naoufalelhlou22/co-detector-controller/audit_rev3/netlist/connectivity.txt

C1 [47uF_35V] 1=+12V, 2=GND
C2 [10uF_50V] 1=+12V, 2=GND
C3 [10uF_50V] 1=+12V, 2=GND
C4 [100nF] 1=+12V, 2=GND
C5 [100nF] 1=BUCK_BOOT, 2=BUCK_SW
C6 [1uF] 1=BUCK_VCC, 2=GND
C7 [DNP] 1=BUCK_FB, 2=+3V3
C8 [22uF_10V] 1=+3V3, 2=GND
C9 [22uF_10V] 1=+3V3, 2=GND
C10 [22uF_10V] 1=+3V3, 2=GND
C11 [22uF_10V] 1=+3V3, 2=GND
C12 [100nF] 1=+3V3, 2=GND
C13 [10uF_10V] 1=AGND, 2=AVDD
C14 [100nF] 1=AGND, 2=AVDD
C15 [10uF_10V] 1=GND, 2=+3V3
C16 [100nF] 1=GND, 2=+3V3
C17 [100nF] 1=VOUT_ADC, 2=GND
C18 [100nF] 1=AGND, 2=AVDD
C19 [100nF] 1=AVDD, 2=AGND
C20 [100nF] 1=VREF, 2=AGND
C21 [1uF] 1=TIA_C1, 2=TIA_C2
C22 [100nF] 1=GND, 2=+3V3
C23 [100nF] 1=GND, 2=+3V3
C24 [100nF_50V] 1=+12V, 2=GND
C25 [100nF] 1=VALVE_SENSE, 2=GND
C26 [100nF_50V] 1=+12V, 2=GND
C27 [100nF] 1=TEST_N, 2=GND
C28 [100nF] 1=GND, 2=LPG_ADC
C29 [100nF] 1=+3V3, 2=GND
C30 [100nF] 1=HUSH_N, 2=GND
C31 [100nF] 1=GND, 2=MR_N
D1 [SMBJ15A] 1=+12V_F, 2=GND
D2 [B240A] 1=+12V, 2=VALVE_NEG
D3 [BZT52C15] 1=+12V, 2=Q1_G
D4 [RED_ALARM] 1=GND, 2=RED_A
D5 [GRN_OK] 1=GND, 2=GRN_A
D6 [BLU_WIFI] 1=BLU_K, 2=BLU_A
D7 [DNP] 1=+12V, 2=BUZ_K
D8 [YLW_FAULT] 1=TEST_N, 2=YLW_A
D9 [TVS_3V3_ESD] 1=TEST_N, 2=GND
D10 [TVS_3V3_ESD] 1=HUSH_N, 2=GND
D11 [TVS_3V3_ESD] 1=MR_N, 2=GND
F1 [1.5A_PTC] 1=+12V_IN, 2=+12V_F
FB1 [220R_100MHz] 1=+3V3, 2=AVDD
FID1 [FID_BL] 
FID2 [FID_TR] 
H1 [M3_NPTH] 
H2 [M3_NPTH] 
H3 [M3_NPTH] 
H4 [M3_NPTH] 
J1 [12V_IN] 1(+12V_IN_1)=+12V_IN, 2(GND_2)=GND
J2 [EXT_ALARM_12V] 1(EXT_ALM+_1)=+12V, 2(EXT_ALM-_2)=VALVE_NEG
J3 [UART_HDR] 1(3V3_1)=+3V3, 2(TX_2)=UART_TX, 3(RX_3)=UART_RX, 4(GND_4)=GND
J4 [OLED_I2C] 1(GND_1)=GND, 2(3V3_2)=+3V3, 3(SCL_3)=I2C_SCL, 4(SDA_4)=I2C_SDA
L1 [6.8uH] 1=BUCK_SW, 2=+3V3
LS1 [CDM-12008_SPKR] 1=+12V, 2=BUZ_K
NT1 [NetTie_AGND_GND] 1=GND, 2=AGND
Q1 [AO3407A] 1(G_1)=Q1_G, 2(S_2)=+12V, 3(D_3)=+12V_F
Q2 [IRLML6344] 1(G_1)=VALVE_GATE, 2(S_2)=GND, 3(D_3)=VALVE_NEG
Q3 [MMBFJ177_DNP] 1(D_1)=unconnected-(Q3-D-Pad1), 2(S_2)=unconnected-(Q3-S-Pad2), 3(G_3)=unconnected-(Q3-G-Pad3)
Q4 [2N7002] 1(G_1)=LED_BLU, 2(S_2)=GND, 3(D_3)=BLU_K
Q5 [AO3400A] 1(G_1)=BUZ_B, 2(S_2)=GND, 3(D_3)=BUZ_K
R1 [10k] 1=Q1_G, 2=GND
R2 [100k] 1=+12V, 2=BUCK_EN
R3 [DNP] 1=BUCK_EN, 2=GND
R4 [100k] 1=BUCK_FB, 2=+3V3
R5 [43.2k] 1=BUCK_FB, 2=GND
R6 [10k_DNP] 1=+3V3, 2=LPG_ADC
R7 [10k] 1=+3V3, 2=HUSH_N
R8 [10k] 1=+3V3, 2=BOOT_N
R9 [4.7k] 1=+3V3, 2=I2C_SDA
R10 [4.7k] 1=+3V3, 2=I2C_SCL
R11 [1k] 1=VOUT_ADC, 2=VOUT
R12 [DNP] 1=TIA_C1, 2=TIA_C2
R13 [10k] 1=VALVE_DRV, 2=VALVE_EN
R14 [100R] 1=VALVE_GATE, 2=VALVE_DRV
R15 [100k] 1=VALVE_GATE, 2=GND
R16 [100k] 1=VALVE_NEG, 2=VALVE_SENSE
R17 [15k] 1=VALVE_SENSE, 2=GND
R18 [DNP] 1=WDI, 2=GND
R19 [270R] 1=LED_RED, 2=RED_A
R20 [330R] 1=GRN_A, 2=+3V3
R21 [2.2k] 1=+12V, 2=BLU_A
R22 [100k] 1=LED_BLU, 2=GND
R23 [100R] 1=BUZZER, 2=BUZ_B
R24 [10k] 1=BUZ_B, 2=GND
R25 [47R] 1=+12V, 2=BUZ_K
R26 [10k] 1=TEST_N, 2=+3V3
R27 [22R_0.25W] 1=+3V3, 2=LPG_HTR
R28 [4.7k] 1=LPG_SNS, 2=GND
R29 [1k] 1=LPG_SNS, 2=LPG_ADC
R30 [330R] 1=+3V3, 2=YLW_A
S1 [ME3-CO] 1(WE_1)=WE, 2(RE_2)=RE, 3(CE_3)=CE
S2 [TGS2610-C00] 1(HTR-_1)=GND, 2(SNS-_2)=LPG_SNS, 3(SNS+_3)=+3V3, 4(HTR+_4)=LPG_HTR
SW1 [TEST_SELF_CHECK] 1=TEST_N, 2=GND
SW2 [HUSH_OLED] 1=HUSH_N, 2=GND
SW3 [HW_MASTER_RST] 1=MR_N, 2=GND
TP1 [+12V] 1(TP_1)=+12V
TP2 [+3V3] 1(TP_1)=+3V3
TP3 [AVDD] 1(TP_1)=AVDD
TP4 [GND] 1(TP_1)=GND
TP5 [VOUT] 1(TP_1)=VOUT
TP6 [VALVE_GATE] 1(TP_1)=VALVE_GATE
TP7 [I2C_SDA] 1(TP_1)=I2C_SDA
TP8 [I2C_SCL] 1(TP_1)=I2C_SCL
TP9 [EN_PAD] 1(TP_1)=MR_N
TP10 [BOOT_PAD] 1(TP_1)=BOOT_N
TP11 [LPG_ADC] 1(TP_1)=LPG_ADC
TP12 [NRST] 1(TP_1)=NRST
U1 [ESP32-C3-MINI-1] 1(GND_1)=GND, 2(GND_2)=GND, 3(3V3_3)=+3V3, 4(NC_4_4)=unconnected-(U1-NC_4-Pad4), 5(IO2_LPG_ADC_5)=LPG_ADC, 6(IO3_BUZZER_6)=BUZZER, 7(NC_7_7)=unconnected-(U1-NC_7-Pad7), 8(EN_NRST_8)=NRST, 9(NC_9_9)=unconnected-(U1-NC_9-Pad9), 10(NC_10_10)=unconnected-(U1-NC_10-Pad10), 11(GND_11)=GND, 12(IO0_VOUT_ADC_12)=VOUT_ADC, 13(IO1_VALVE_SNS_13)=VALVE_SENSE, 14(GND_14)=GND, 15(NC_15_15)=unconnected-(U1-NC_15-Pad15), 16(IO10_TEST_N_16)=TEST_N, 17(NC_17_17)=unconnected-(U1-NC_17-Pad17), 18(IO4_SDA_18)=I2C_SDA, 19(IO5_SCL_19)=I2C_SCL, 20(IO6_VALVE_EN_20)=VALVE_EN, 21(IO7_WDI_21)=WDI, 22(IO8_HUSH_N_22)=HUSH_N, 23(IO9_BOOT_N_23)=BOOT_N, 24(NC_24_24)=unconnected-(U1-NC_24-Pad24), 25(NC_25_25)=unconnected-(U1-NC_25-Pad25), 26(IO18_LED_RED_26)=LED_RED, 27(IO19_LED_BLU_27)=LED_BLU, 28(NC_28_28)=unconnected-(U1-NC_28-Pad28), 29(NC_29_29)=unconnected-(U1-NC_29-Pad29), 30(RXD0_30)=UART_RX, 31(TXD0_31)=UART_TX, 32(NC_32_32)=unconnected-(U1-NC_32-Pad32), 33(NC_33_33)=unconnected-(U1-NC_33-Pad33), 34(NC_34_34)=unconnected-(U1-NC_34-Pad34), 35(NC_35_35)=unconnected-(U1-NC_35-Pad35), 36(GND_36)=GND, 37(GND_37)=GND, 38(GND_38)=GND, 39(GND_39)=GND, 40(GND_40)=GND, 41(GND_41)=GND, 42(GND_42)=GND, 43(GND_43)=GND, 44(GND_44)=GND, 45(GND_45)=GND, 46(GND_46)=GND, 47(GND_47)=GND, 48(GND_48)=GND, 49(GND_49)=GND, 50(GND_50)=GND, 51(GND_51)=GND, 52(GND_52)=GND, 53(GND_53)=GND
U2 [LMR33620ADDAR] 1(PGND_1)=GND, 2(VIN_2)=+12V, 3(EN_3)=BUCK_EN, 4(PG_4)=unconnected-(U2-PG-Pad4), 5(FB_5)=BUCK_FB, 6(VCC_6)=BUCK_VCC, 7(BOOT_7)=BUCK_BOOT, 8(SW_8)=BUCK_SW, 9(GND_9)=GND
U3 [LMP91000SDE] 1(DGND_1)=AGND, 2(MENB_2)=AGND, 3(SCL_3)=I2C_SCL, 4(SDA_4)=I2C_SDA, 5(NC_5)=unconnected-(U3-NC-Pad5), 6(VDD_6)=AVDD, 7(AGND_7)=AGND, 8(VOUT_8)=VOUT, 9(C2_9)=TIA_C2, 10(C1_10)=TIA_C1, 11(VREF_11)=VREF, 12(WE_12)=WE, 13(RE_13)=RE, 14(CE_14)=CE, 15(GND_15)=AGND
U4 [REF3325] 1(IN_1)=AVDD, 2(OUT_2)=VREF, 3(GND_3)=AGND
U5 [74LVC1G08] 1(A_1)=VALVE_EN, 2(B_2)=VALVE_EN, 3(GND_3)=GND, 4(Y_4)=VALVE_DRV, 5(VCC_5)=+3V3
U6 [TPS3823-33] 1(~{RESET}_1)=NRST, 2(GND_2)=GND, 3(~{MR}_3)=MR_N, 4(WDI_4)=WDI, 5(VDD_5)=+3V3

==== NETS ====
+12V: C1.1 C2.1 C24.1 C26.1 C3.1 C4.1 D2.1 D3.1 D7.1 J2.1 LS1.1 Q1.2 R2.1 R21.1 R25.1 TP1.1 U2.2
+12V_F: D1.1 F1.2 Q1.3
+12V_IN: F1.1 J1.1
+3V3: C10.1 C11.1 C12.1 C15.2 C16.2 C22.2 C23.2 C29.1 C7.2 C8.1 C9.1 FB1.1 J3.1 J4.2 L1.2 R10.1 R20.2 R26.2 R27.1 R30.1 R4.2 R6.1 R7.1 R8.1 R9.1 S2.3 TP2.1 U1.3 U5.5 U6.5
AGND: C13.1 C14.1 C18.1 C19.2 C20.2 NT1.2 U3.1 U3.15 U3.2 U3.7 U4.3
AVDD: C13.2 C14.2 C18.2 C19.1 FB1.2 TP3.1 U3.6 U4.1
BLU_A: D6.2 R21.2
BLU_K: D6.1 Q4.3
BOOT_N: R8.2 TP10.1 U1.23
BUCK_BOOT: C5.1 U2.7
BUCK_EN: R2.2 R3.1 U2.3
BUCK_FB: C7.1 R4.1 R5.1 U2.5
BUCK_SW: C5.2 L1.1 U2.8
BUCK_VCC: C6.1 U2.6
BUZZER: R23.1 U1.6
BUZ_B: Q5.1 R23.2 R24.1
BUZ_K: D7.2 LS1.2 Q5.3 R25.2
CE: S1.3 U3.14
GND: C1.2 C10.2 C11.2 C12.2 C15.1 C16.1 C17.2 C2.2 C22.1 C23.1 C24.2 C25.2 C26.2 C27.2 C28.1 C29.2 C3.2 C30.2 C31.1 C4.2 C6.2 C8.2 C9.2 D1.2 D10.2 D11.2 D4.1 D5.1 D9.2 J1.2 J3.4 J4.1 NT1.1 Q2.2 Q4.2 Q5.2 R1.2 R15.2 R17.2 R18.2 R22.2 R24.2 R28.2 R3.2 R5.2 S2.1 SW1.2 SW2.2 SW3.2 TP4.1 U1.1 U1.11 U1.14 U1.2 U1.36 U1.37 U1.38 U1.39 U1.40 U1.41 U1.42 U1.43 U1.44 U1.45 U1.46 U1.47 U1.48 U1.49 U1.50 U1.51 U1.52 U1.53 U2.1 U2.9 U5.3 U6.2
GRN_A: D5.2 R20.1
HUSH_N: C30.1 D10.1 R7.2 SW2.1 U1.22
I2C_SCL: J4.3 R10.2 TP8.1 U1.19 U3.3
I2C_SDA: J4.4 R9.2 TP7.1 U1.18 U3.4
LED_BLU: Q4.1 R22.1 U1.27
LED_RED: R19.1 U1.26
LPG_ADC: C28.2 R29.2 R6.2 TP11.1 U1.5
LPG_HTR: R27.2 S2.4
LPG_SNS: R28.1 R29.1 S2.2
MR_N: C31.2 D11.1 SW3.1 TP9.1 U6.3
NRST: TP12.1 U1.8 U6.1
Q1_G: D3.2 Q1.1 R1.1
RE: S1.2 U3.13
RED_A: D4.2 R19.2
TEST_N: C27.1 D8.1 D9.1 R26.1 SW1.1 U1.16
TIA_C1: C21.1 R12.1 U3.10
TIA_C2: C21.2 R12.2 U3.9
UART_RX: J3.3 U1.30
UART_TX: J3.2 U1.31
VALVE_DRV: R13.1 R14.2 U5.4
VALVE_EN: R13.2 U1.20 U5.1 U5.2
VALVE_GATE: Q2.1 R14.1 R15.1 TP6.1
VALVE_NEG: D2.2 J2.2 Q2.3 R16.1
VALVE_SENSE: C25.1 R16.2 R17.1 U1.13
VOUT: R11.2 TP5.1 U3.8
VOUT_ADC: C17.1 R11.1 U1.12
VREF: C20.1 U3.11 U4.2
WDI: R18.1 U1.21 U6.4
WE: S1.1 U3.12
YLW_A: D8.2 R30.2
unconnected-(Q3-D-Pad1): Q3.1
unconnected-(Q3-G-Pad3): Q3.3
unconnected-(Q3-S-Pad2): Q3.2
unconnected-(U1-NC_10-Pad10): U1.10
unconnected-(U1-NC_15-Pad15): U1.15
unconnected-(U1-NC_17-Pad17): U1.17
unconnected-(U1-NC_24-Pad24): U1.24
unconnected-(U1-NC_25-Pad25): U1.25
unconnected-(U1-NC_28-Pad28): U1.28
unconnected-(U1-NC_29-Pad29): U1.29
unconnected-(U1-NC_32-Pad32): U1.32
unconnected-(U1-NC_33-Pad33): U1.33
unconnected-(U1-NC_34-Pad34): U1.34
unconnected-(U1-NC_35-Pad35): U1.35
unconnected-(U1-NC_4-Pad4): U1.4
unconnected-(U1-NC_7-Pad7): U1.7
unconnected-(U1-NC_9-Pad9): U1.9
unconnected-(U2-PG-Pad4): U2.4
unconnected-(U3-NC-Pad5): U3.5
