naoufalelhlou22/co-detector-controller/audit_rev3/spice/spice_simulation_plots.png

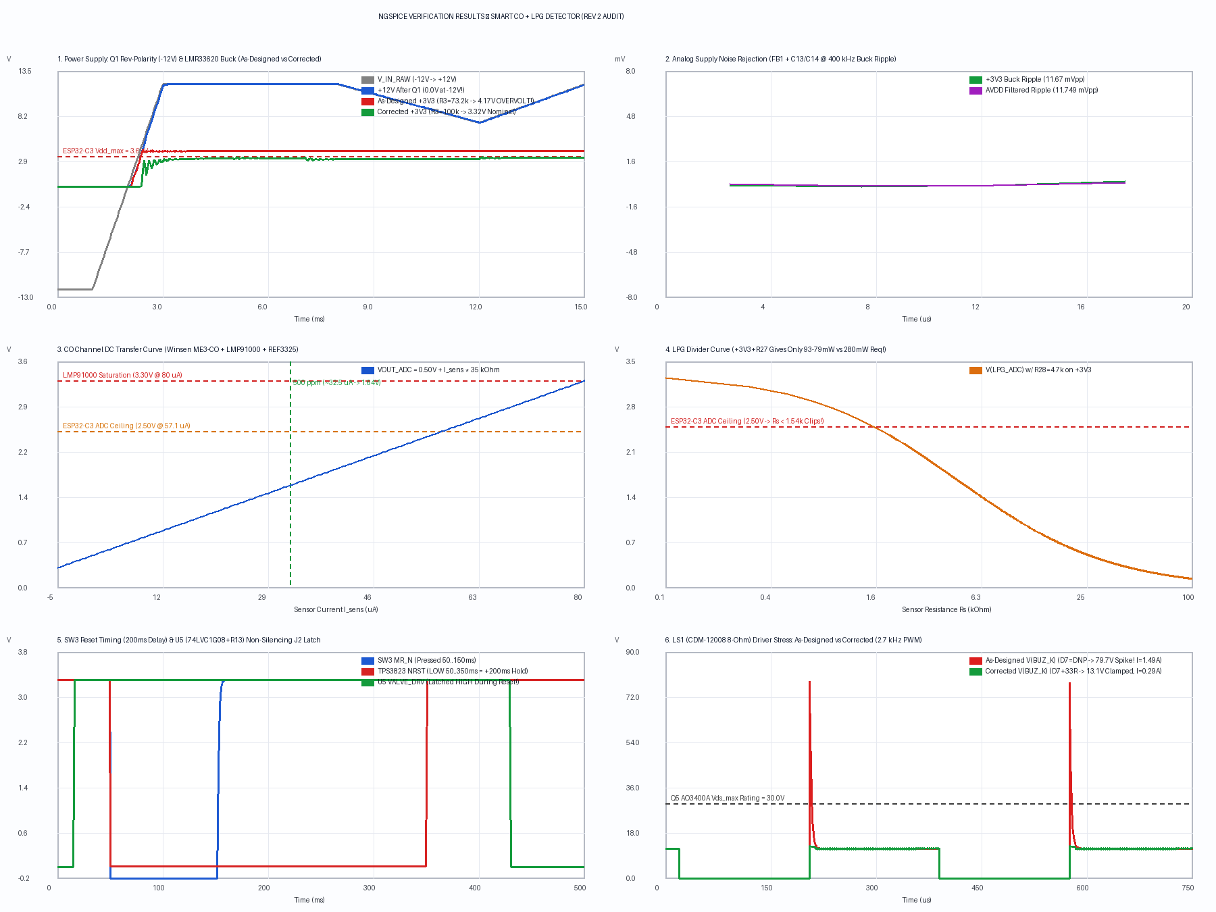
audit_rev3/spice/spice_simulation_plots.png
