naoufalelhlou22/co-detector-controller/JLCPCB_BOM.csv

Comment | Designator | Footprint | LCSC Part #
100nF 50V X7R | C4,C5,C12,C14,C16,C17,C18,C19,C20,C22,C23,C24,C25,C26,C27,C28,C29,C30,C31 | 0603 | C14663
1uF 16V X7R | C6,C21 | 0603 | C15849
10uF 10V X7R | C13,C15 | 0805 | C15850
22uF 25V X5R | C8,C9,C10,C11 | 1206 | C159045
10uF 50V X7R | C2,C3 | 1210
47uF 35V SMD Electrolytic | C1 | SMD-6.3x7.7
10k 1% | R1,R7,R8,R13,R24,R26 | 0603 | C25804
100k 1% | R2,R4,R15,R16,R22 | 0603 | C25803
4.7k 1% | R9,R10,R28 | 0603 | C23162
1k 1% | R11,R29 | 0603 | C22548
100R 1% | R14,R23 | 0603 | C22775
15k 1% | R17 | 0603 | C22809
270R 1% | R19 | 0603 | C22966
330R 1% | R20,R30 | 0603 | C23138
2.2k 1% | R21,R25 | 0603 | C4190
0R Jumper | R27 | 0603 | C21189
43.2k 1% | R5 | 0603 | C2930102
1N4148W | D7 | SOD-123 | C81598
Red LED 0603 | D4 | 0603 | C434419
Green LED 0603 | D5 | 0603 | C965805
Blue LED 0603 | D6 | 0603 | C2986058
Yellow LED 0603 | D8 | 0603 | C965805
SS24 Schottky 40V 2A | D2 | SMA | C2887543
SMBJ15CA TVS 15V | D1 | SMB | C135047
BZT52C15 15V Zener | D3 | SOD-123 | C2104
ESD TVS 3.3V | D9,D10,D11 | 0603 | C15975
ESP32-C3-MINI-1-N4 | U1 | ESP32-C3-MINI-1 | C2838502
LMR33620ADDAR | U2 | SOIC-8-1EP | C2071694
REF3325AIDBZR | U4 | SOT-23 | C69039
SN74LVC1G08DBVR | U5 | SOT-23-5 | C434068
TPS3823-33DBVR | U6 | SOT-23-5 | C7719
LMP91000SDE/NOPB | U3 | WSON-14-1EP | C181364
AO3407A | Q1 | SOT-23 | C181093
AO3400A | Q2,Q5 | SOT-23 | C20917
2N7002 | Q4 | SOT-23 | C8545
TS-1187A Tact Switch | SW1,SW2,SW3 | PTS647 | C318884
Ferrite Bead 220R | FB1 | 0603 | C139160
PTC Fuse 1.5A 24V | F1 | 1812 | C209713
6.8uH Power Inductor | L1 | 5040_5030 | C495812
5.08mm 2P Terminal Block | J1,J2 | 5.08mm-2P | C8465
Pin Header 1x4 2.54mm | J3,J4 | 2.54mm-1x4 | C2255
Buzzer 12V 85dB | LS1 | PS1240P02BT | C96465
