naoufalelhlou22/co-detector-controller/reports/BOM_engineering_master.csv

Item | Designator | Qty | Value / Description | Manufacturer | MPN (Assumed - Verify Before Order) | Footprint | Mount Type | Assembly Status | Zone / Block | Assembly Notes
1 | U1 | 1 | ESP32-C3 Wi-Fi/BLE Module (4MB Flash | PCB Antenna) | Espressif Systems | ESP32-C3-MINI-1-N4 | Custom:ESP32-C3-MINI-1 | SMD | Populate | Zone C (MCU) | Keep antenna window x=29..43 y=44..50 clear; GPIO9 reserved strictly for TP10 service boot pad
2 | U2 | 1 | Synchronous Buck Converter 3.8-36V 2A 400kHz | Texas Instruments | LMR33620ADDAR | Package_SO:TI_SO-PowerPAD-8_ThermalVias | SMD | Populate | Zone A (Power) | Solder exposed PowerPAD to GND thermal vias
3 | U3 | 1 | Programmable Electrochemical Potentiostat AFE (I2C) | Texas Instruments | LMP91000SDE/NOPB | Package_SON:WSON-14-1EP_4.0x4.0mm_P0.5mm_EP2.6x2.6mm | SMD | Populate | Zone D (Analog AFE) | Solder exposed DAP to AGND
4 | U4 | 1 | Precision 2.500V Series Voltage Reference (0.15%) | Texas Instruments | REF3325AIDBZR | Package_TO_SOT_SMD:SOT-23 | SMD | Populate | Zone D (Analog AFE) | External VREF for LMP91000
5 | U5 | 1 | Single Non-Inverting Buffer / CMOS Bus-Hold Latch (External Alarm Driver) | Texas Instruments | SN74LVC1G08DBVR | Package_TO_SOT_SMD:SOT-23-5 | SMD | Populate | Zone B (Ext Alarm) | Tied A=B=VALVE_EN with R13=10k feedback from Y(VALVE_DRV) so active alarm J2 is never silenced during SW3/NRST reset
6 | U6 | 1 | Supply Voltage Supervisor & Hardware Watchdog (2.93V | 1.6s WDT | 200ms Reset Delay) | Texas Instruments | TPS3823-33DBVR | Package_TO_SOT_SMD:SOT-23-5 | SMD | Populate | Zone B (Supervisor) | Pin 3 (~MR) driven by recessed SW3; asserts ~RESET low for full duration of SW3 press + 200ms post-release delay
7 | Q1 | 1 | P-Channel MOSFET -30V Vgs=+-20V (Reverse-Polarity Protection) | Alpha & Omega Semiconductor | AO3407A | Package_TO_SOT_SMD:SOT-23 | SMD | Populate | Zone A (Power) | Low-drop high-side reverse polarity switch
8 | Q2 | 1 | Logic-Level N-Channel MOSFET 30V 37mOhm@2.5V (External Alarm Driver) | Infineon Technologies | IRLML6344TRPBF | Package_TO_SOT_SMD:SOT-23 | SMD | Populate | Zone B (Ext Alarm) | 2x2 thermal via array on drain copper island
9 | Q3 | 0 | P-Channel JFET WE-RE Depolarization Short (Optional) | onsemi | MMBFJ177LT1G | Package_TO_SOT_SMD:SOT-23 | SMD | DNP | Zone D (Analog AFE) | DNP: LMP91000 internal FET_SHORT used to avoid RE/WE stubs
10 | Q4 | 1 | N-Channel Small-Signal MOSFET 60V (Blue LED Driver) | Nexperia | 2N7002,215 | Package_TO_SOT_SMD:SOT-23 | SMD | Populate | Zone E (HMI) | Switches 12V-fed blue LED from 3.3V GPIO19
11 | Q5 | 1 | Logic-Level N-Channel MOSFET 30V 5.7A 26mOhm (Audio Speaker Driver) | Alpha & Omega Semiconductor | AO3400A | Package_TO_SOT_SMD:SOT-23 | SMD | Populate | Zone E (HMI) | High-current PWM/Sigma-Delta audio driver for LS1 dynamic speaker
12 | D1 | 1 | Bidirectional TVS Diode 15V 600W SMB (IEC 61000-4-2) | Littelfuse | SMBJ15CA | Diode_SMD:D_SMB | SMD | Populate | Zone A (Power) | Bidirectional TVS (no cathode bar): eliminates forward conduction crowbar under -12V reverse polarity
13 | D2 | 1 | Schottky Flyback Diode 40V 2A SMA | Diodes Incorporated | B240A-13-F | Diode_SMD:D_SMA | SMD | Populate | Zone B (Ext Alarm) | Directly across J2 external alarm terminals (Cathode to +12V)
14 | D3 | 1 | Zener Diode 15V 500mW SOD-123 (Q1 Vgs Clamp) | Diodes Incorporated | BZT52C15-7-F | Diode_SMD:D_SOD-123 | SMD | Populate | Zone A (Power) | Clamps Q1 Vgs within +-20V rating
15 | D4 | 1 | Red Alarm Status LED 0603 (625nm) | Kingbright | APT1608EC | LED_SMD:LED_0603_1608Metric | SMD | Populate | Zone E (HMI) | Active-HIGH CO/LPG Danger Alarm LED on GPIO18 (~4.8 mA via R19=270R)
16 | D5 | 1 | Green Power Supply Status LED 0603 (570nm | EN 50291-1 / EN 50194-1) | Kingbright | APT1608SGC | LED_SMD:LED_0603_1608Metric | SMD | Populate | Zone E (HMI) | Direct hardware +3V3 supply indicator (~3.6 mA via R20=330R to GND)
17 | D6 | 1 | Blue Wi-Fi Status LED 0603 (465nm) | Kingbright | APT1608QBC/D | LED_SMD:LED_0603_1608Metric | SMD | Populate | Zone E (HMI) | Driven via Q4 N-MOSFET from +12V rail (~4.1 mA via R21=2.2k)
18 | D8 | 1 | Amber/Yellow Fault & Self-Test Status LED 0603 (590nm | EN 50291-1 / EN 50194-1) | Kingbright | APT1608SYCK | LED_SMD:LED_0603_1608Metric | SMD | Populate | Zone E (HMI) | Active-LOW Fault / Sensor Warm-Up / SW1 Self-Test LED on GPIO10 (~3.9 mA via R30=330R)
19 | D9,D10,D11 | 3 | Low-Capacitance TVS ESD Protection Diode 3.3V +-30kV IEC 61000-4-2 0603 | Bourns / Littelfuse | CD0603-T03C / SP1003-01ETG | Diode_SMD:D_0603_1608Metric | SMD | Populate | Zone E / Zone B | Dedicated IEC 61000-4-2 ESD clamps across SW1 (D9) | SW2 (D10) | and SW3 (D11) with short local GND vias
20 | D7 | 1 | Fast Switching Flyback Diode 100V 300mA SOD-123 | Diodes Incorporated | 1N4148W-7-F | Diode_SMD:D_SOD-123 | SMD | Populate | Zone E (HMI) | Inductive flyback clamp diode across LS1/Q5 (Cathode to +12V); protects Q5 AO3400A from 82V inductive turn-off spike
21 | F1 | 1 | Resettable PTC Fuse 1.5A Hold / 3.0A Trip 24V 1812 | Bourns | MF-MSMF150/24X-2 | Fuse:Fuse_1812_4532Metric | SMD | Populate | Zone A (Power) | Series input overcurrent protection
22 | L1 | 1 | Shielded Power Inductor 6.8uH Isat=3.6A DCR=40mOhm | Coilcraft | XAL5030-682MEC | Inductor_SMD:L_Coilcraft_XAL5030-XXX | SMD | Populate | Zone A (Power) | Buck converter output inductor
23 | FB1 | 1 | Ferrite Bead 220Ohm@100MHz 1.4A DCR=100mOhm 0603 | Murata | BLM18PG221SN1D | Inductor_SMD:L_0603_1608Metric | SMD | Populate | Zone D (Analog AFE) | Analog supply filter (+3V3 -> AVDD)
24 | C1 | 1 | Aluminum Electrolytic Capacitor 47uF 35V SMD 6.3x7.7mm | Panasonic | EEE-FK1V470P | Capacitor_SMD:CP_Elec_6.3x7.7 | SMD | Populate | Zone A (Power) | Bulk input damping capacitor
25 | C2,C3 | 2 | Ceramic Capacitor 10uF 50V X7R 1210 | Murata | GRM32ER71H106KA12L | Capacitor_SMD:C_1210_3225Metric | SMD | Populate | Zone A (Power) | Buck high-current input decoupling
26 | C8,C9,C10,C11 | 4 | Ceramic Capacitor 22uF 10V X7R 1206 | Murata | GRM31CR71A226KE15L | Capacitor_SMD:C_1206_3216Metric | SMD | Populate | Zone A (Power) | Buck output capacitor bank
27 | C13,C15 | 2 | Ceramic Capacitor 10uF 10V X7R 0805 | Murata | GRM21BR71A106KA73L | Capacitor_SMD:C_0805_2012Metric | SMD | Populate | Zone C / Zone D | AVDD bulk cap (C13) and ESP32-C3 bulk cap (C15)
28 | C6,C21 | 2 | Ceramic Capacitor 1uF 16V X7R 0603 | Murata | GRM188R71C105KA12D | Capacitor_SMD:C_0603_1608Metric | SMD | Populate | Zone A / Zone D | LMR33620 VCC bypass (C6) & LMP91000 TIA filter cap (C21)
29 | C4,C5,C12,C14,C16,C17,C18,C19,C20,C22,C23,C24,C25,C26,C27,C28,C29,C30,C31 | 19 | Ceramic Capacitor 100nF 50V X7R 0603 | Murata | GRM188R71H104KA93D | Capacitor_SMD:C_0603_1608Metric | SMD | Populate | All Zones | 100nF local decoupling & RC debouncing capacitors (C27/C30/C31 provide tau=1ms hardware RC switch debouncing)
30 | C7 | 0 | Ceramic Capacitor 22pF 50V C0G 0603 (Buck Cff Option) | Murata | GRM1885C1H220JA01D | Capacitor_SMD:C_0603_1608Metric | SMD | DNP | Zone A (Power) | Optional buck feedback phase-lead capacitor
31 | R1,R7,R8,R13,R24,R26 | 6 | Thick Film Resistor 10kOhm 1% 0.1W 0603 | Yageo | RC0603FR-0710KL | Resistor_SMD:R_0603_1608Metric | SMD | Populate | All Zones | Pull-up/down & bus-hold resistors (R13 = 10k U5 output-to-input bus-hold feedback; R8 = 10k GPIO9 pull-up)
32 | R2,R4,R15,R16,R22 | 5 | Thick Film Resistor 100kOhm 1% 0.1W 0603 | Yageo | RC0603FR-07100KL | Resistor_SMD:R_0603_1608Metric | SMD | Populate | All Zones | R15 = 100k external alarm MOSFET gate safety pull-down
33 | R5 | 1 | Thick Film Resistor 43.2kOhm 1% 0.1W 0603 | Yageo | RC0603FR-0743K2L | Resistor_SMD:R_0603_1608Metric | SMD | Populate | Zone A (Power) | Sets buck output to 3.315V with R4=100k
34 | R9,R10,R28 | 3 | Thick Film Resistor 4.7kOhm 1% 0.1W 0603 | Yageo | RC0603FR-074K7L | Resistor_SMD:R_0603_1608Metric | SMD | Populate | Zone C / Zone F | I2C pull-ups (R9 | R10) and precision 1% LPG sensor load resistor RL (R28)
35 | R21 | 1 | Thick Film Resistor 2.2kOhm 1% 0.1W 0603 | Yageo | RC0603FR-072K2L | Resistor_SMD:R_0603_1608Metric | SMD | Populate | Zone E (HMI) | Matched 4.1mA current limiter for +12V MOSFET-driven Blue Wi-Fi LED (D6)
36 | R11,R29 | 2 | Thick Film Resistor 1kOhm 1% 0.1W 0603 | Yageo | RC0603FR-071KL | Resistor_SMD:R_0603_1608Metric | SMD | Populate | Zone D / Zone F | ADC RC anti-aliasing filter resistors for CO channel (R11) and LPG channel (R29)
37 | R17 | 1 | Thick Film Resistor 15kOhm 1% 0.1W 0603 | Yageo | RC0603FR-0715KL | Resistor_SMD:R_0603_1608Metric | SMD | Populate | Zone B (Ext Alarm) | Lower leg of EXT_ALM_SENSE continuity/fault divider
38 | R14,R23 | 2 | Thick Film Resistor 100Ohm 1% 0.1W 0603 | Yageo | RC0603FR-07100RL | Resistor_SMD:R_0603_1608Metric | SMD | Populate | Zone B / Zone E | Gate damping resistors for Q2 external alarm MOSFET (R14) & Q5 speaker MOSFET (R23)
39 | R19 | 1 | Thick Film Resistor 270Ohm 1% 0.1W 0603 | Yageo | RC0603FR-07270RL | Resistor_SMD:R_0603_1608Metric | SMD | Populate | Zone E (HMI) | Red Alarm LED (D4) current limiting resistor (~4.8 mA)
40 | R20,R30 | 2 | Thick Film Resistor 330Ohm 1% 0.1W 0603 | Yageo | RC0603FR-07330RL | Resistor_SMD:R_0603_1608Metric | SMD | Populate | Zone E (HMI) | Matched current limiting resistors for Green Power LED D5 (R20) & Yellow Fault LED D8 (R30)
41 | R25 | 1 | Thick Film Resistor 2.2kOhm 1% 0.1W 0603 | Yageo | RC0603FR-072K2L | Resistor_SMD:R_0603_1608Metric | SMD | Populate | Zone E (HMI) | Buzzer damping resistor for TDK PS1240P02BT (if 8R CDM-12008 speaker is used: mark DNP and add inline 33R 2W series limiter)
42 | R27 | 1 | Thick Film Jumper Resistor 0.0Ohm 0603 (LPG Heater 5V Link) | Yageo | RC0603JR-070RL | Resistor_SMD:R_0603_1608Metric | SMD | Populate | Zone F (LPG Sensor) | Direct 5.0V heater link for S2 (TGS2610 requires Vh=5.0V +-0.2V | Ih=56mA | Ph=280mW per Figaro datasheet)
43 | R3,R6,R12,R18 | 0 | Optional 0603 Resistors (UVLO / IO2 Pull-Up / Ext RTIA / WDI Pull-Down) | - | - | Resistor_SMD:R_0603_1608Metric | SMD | DNP | Zone A/B/C/D | DNP options
44 | J1,J2 | 2 | PCB Terminal Block 2-Pos 5.08mm Pitch 15A | Phoenix Contact | 1729128 | TerminalBlock_Phoenix:MKDS-1 | 5-2-5.08_Centered | THT | Populate | Zone A / Zone B | J1 = 12V DC Input; J2 = 12V External Alarm / Siren / Strobe / Relay Output
45 | J3,J4 | 2 | Vertical Pin Header 1x04 2.54mm Pitch (UART Debug & I2C OLED Display) | Wurth Elektronik | 61300411121 | Connector_PinHeader_2.54mm:PinHeader_1x04_P2.54mm_Vertical | THT | Populate | Zone C / Zone E | J3 = UART Debug; J4 = 0.96in I2C SSD1306 OLED Display (1=GND | 2=+3V3 | 3=SCL | 4=SDA)
46 | SW1,SW2,SW3 | 3 | Tactile Switch SPST-NO Top Actuated 4.5x4.5mm SMD (Color-Coded Actuators) | C&K | PTS647SN50SMTR2LFS | Button_Switch_SMD:SW_SPST_PTS647_Sx50 | SMD | Populate | Zone E / Zone B | SW1 = Test + Diagnostics on GPIO10 (Yellow); SW2 = Temporary Hush + OLED Nav on GPIO8 (Blue); SW3 = Recessed Maintenance Hardware Reset on TPS3823 ~MR (Red)
47 | LS1 | 1 | Magnetic/Piezo Buzzer 12V 85dB D12.2mm H6.5mm (or 8R Speaker w/ 33R Limiter) | TDK / CUI Devices | PS1240P02BT / CDM-12008 | Buzzer_Beeper:Buzzer_TDK_PS1240P02BT_D12.2mm_H6.5mm | THT | Populate | Zone E (HMI) | Footprint fits TDK PS1240P02BT sounder; if CDM-12008 8R speaker is used | install with 33R 2W inline resistor
48 | S1_SOCKETS | 3 | THT Pin Receptacle Socket for 0.8mm Sensor Pins (Drill 1.4mm) | Mill-Max | 0305-2-15-80-47-80-10-0 | Custom:Winsen_ME3-CO_Socket | THT | Populate | Zone D (Analog AFE) | Solder 3x receptacle sockets during THT wave/hand solder
49 | S1 | 1 | 3-Electrode Electrochemical CO Gas Sensor (0-1000 ppm | EN 50291-1) | Winsen | ME3-CO | Custom:Winsen_ME3-CO_Socket | Post-Assembly Plug-In | Insert AFTER Wash/Reflow | Zone D (Analog AFE) | DO NOT REFLOW | DO NOT WASH | DO NOT CONFORMAL COAT! Plug into S1 sockets at final test
50 | S2 | 1 | Combustible LPG / Propane / Butane Gas Sensor TO-5-4 (500-10000 ppm | EN 50194-1) | Figaro Engineering | TGS2610-C00 | Custom:Figaro_TGS2610_TO5 | THT | Populate (Thermally Isolated Zone F) | Zone F (LPG Sensor) | Double-layer SUS316 flameproof mesh; thermally isolated above Zone D thermal barrier; Vh=5.0V powered
51 | U7 | 1 | Linear Voltage Regulator 5.0V 100mA SOT-89 (LPG Heater Supply) | JCET | CJ78L05 | Package_TO_SOT_SMD:SOT-89-3 | SMD | Populate | Zone F (LPG Sensor) | Dedicated 5.0V heater supply for S2 (Vin=+12V | Vout=+5.0V | Iq=3mA | Basic Part LCSC C22080)
52 | C32,C33 | 2 | Ceramic Capacitor 1uF 16V X7R 0603 (5V LDO Decoupling) | Murata | GRM188R71C105KA12D | Capacitor_SMD:C_0603_1608Metric | SMD | Populate | Zone F (LPG Sensor) | U7 5V regulator input (C32 on +12V) and output (C33 on +5V) decoupling capacitors
53 | NT1 | 1 | 2-Pad Copper Net-Tie (Single-Point AGND-to-GND Join) | PCB Copper Feature | PCB_NETTIE_0.5MM | NetTie:NetTie-2_SMD_Pad0.5mm | PCB | Fabricated on PCB | Zone D (Analog AFE) | No physical component to place
54 | TP1-TP12 | 12 | 1.5mm Surface Test Point Pad (ENIG) | PCB Copper Feature | PCB_TP_1.5MM | TestPoint:TestPoint_Pad_D1.5mm | PCB | Fabricated on PCB | All Zones | TP10 = Dedicated Service Boot Pad (GPIO9); no physical component to place
55 | FID1,FID2 | 2 | 1.0mm Copper / 2.0mm Mask Global Optical Fiducial | PCB Copper Feature | PCB_FIDUCIAL_1MM | Fiducial:Fiducial_1mm_Mask2mm | PCB | Fabricated on PCB | Global | No physical component to place
56 | H1-H4 | 4 | 3.2mm Non-Plated Through-Hole for M3 Mounting Screw | PCB Mechanical Feature | PCB_NPTH_3.2MM | MountingHole:MountingHole_3.2mm_M3 | PCB | Fabricated on PCB | Corners | 3.5mm from board edges
