naoufalelhlou22/co-detector-controller/co_detector_controller.step

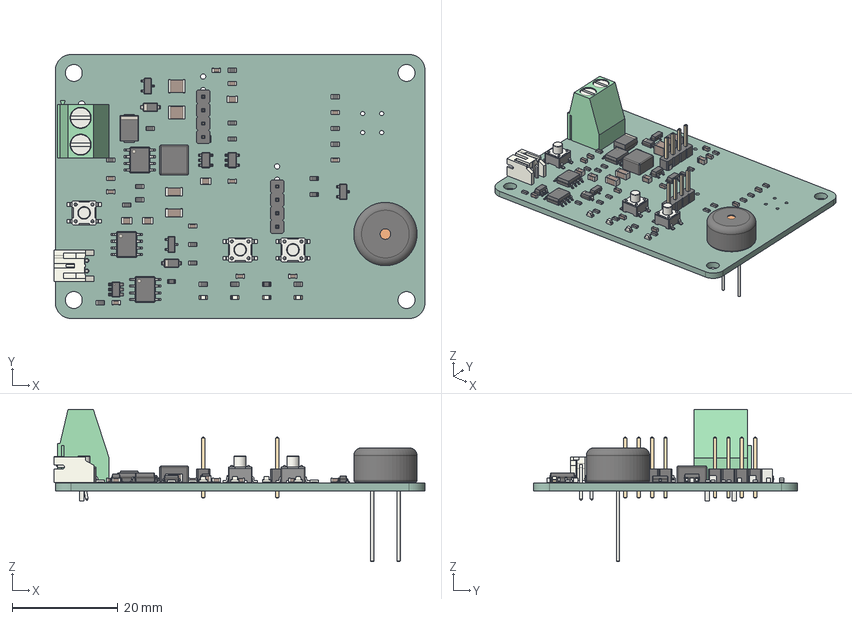
[picture p2: CAD file, 2026-11-08]
co_detector_controller.step
70.2 x 50.0 x 28.8 mm
LED_0603_1608Metric x 4
C_1210_3225Metric x 2
R_0603_1608Metric x 21
C_1206_3216Metric x 2
SOT-23-6
SOIC-8_3.9x4.9mm_P1.27mm x 3
C_0805_2012Metric x 5
SOT-23 x 3
C_0603_1608Metric x 11
JST_S2B_PH_K
D_SOD-123 x 2
PinHeader_1x04_P254mm_Vertical x 2
SW_SPST_PTS647Sx50 x 3
L_Coilcraft_XAL5030-XXX
Buzzer_TDK_PS1240P02BT_D122mm_H65mm
SOT-23-5 x 2
D_SMB
TerminalBlock_Phoenix_MKDS-1,5-2-5.08_1x02_P5.08mm_Horizontal
co_detector_controller_PCB
