naoufalelhlou22/co-detector-controller/audit_rev3/wokwi/test/test_18_results.txt

=== Smart CO+LPG Detector — 18-Scenario Firmware Verification ===

S01: Normal cold startup (power-on, warmup -> normal)
S02: Elevated CO (50 ppm sustained -> alarm after ~75 min accumulator)
S03: High CO 300 ppm -> alarm within policy window
S04: LPG alarm (>10% LEL sustained for 5 s)
S05: Simultaneous CO + LPG alarm -> ALARM_DUAL, hush rejected
S06: CO sensor disconnected (open cell)
S07: LPG sensor disconnected (Rs -> infinity, V_ADC ~ 0)
S08: CO out-of-range (ADC saturation > 2450 mV) -> overrange alarm
S09: LPG ADC clipping (V > 2450 mV, Rs < ~1.65 kOhm)
S10: OLED I2C failure (non-blocking, safety loop continues)
S11: SW1 TEST button press -> 3 s self-test cycle
S12: Hush during CO alarm, then expiration
S13: SW3 hardware reset during active alarm -> U5 latch holds J2
S14: Watchdog reset with no alarm -> boot to WARMUP/NORMAL
S15: Power interruption -> cold boot, full warmup required
S16: Recovery: alarm -> clean air -> auto-clear
S17: GPIO10 shared pin — D8 LED lit, SW1 must still be readable
S18: WDI kicker — toggles every 500 ms when healthy, stops when unhealthy

=== RESULTS: 66 PASSED, 0 FAILED out of 66 total ===
