naoufalelhlou22/co-detector-controller/co_detector_controller.kicad_pcb

## KiCad design co_detector_controller.kicad_pcb (2026-11-08)

Schematic: co_detector_controller.kicad_sch, CO Detector & Automatic 12V Gas Shut-Off Valve Controller

Parts:
C1: 47uF_35V; CP_Elec_6.3x7.7
C2, C3: 10uF_50V; C_1210_3225Metric
C4, C5, C12, C14, C16, C17, C18, C19, C20, C22, C23, C25, C27, C28, C29, C30, C31: 100nF; C_0603_1608Metric
C6, C21: 1uF; C_0603_1608Metric
C7: DNP; C_0603_1608Metric
C8, C9, C10, C11: 22uF_10V; C_1206_3216Metric
C13, C15: 10uF_10V; C_0805_2012Metric
C24, C26: 100nF_50V; C_0603_1608Metric
D1: SMBJ15CA; D_SMB
D2: B240A; D_SMA
D3: BZT52C15; D_SOD-123
D4: RED_ALARM; LED_0603_1608Metric
D5: GRN_OK; LED_0603_1608Metric
D6: BLU_WIFI; LED_0603_1608Metric
D7: 1N4148W; D_SOD-123
D8: YLW_FAULT; LED_0603_1608Metric
D9, D10, D11: TVS_3V3_ESD; D_0603_1608Metric
F1: 1.5A_PTC; Fuse_1812_4532Metric
FB1: 220R_100MHz; L_0603_1608Metric
FID1: FID_BL; Fiducial_1mm_Mask2mm
FID2: FID_TR; Fiducial_1mm_Mask2mm
H1, H2, H3, H4: M3_NPTH; MountingHole_3.2mm_M3
J1: 12V_IN; TerminalBlock_Phoenix_MKDS-1,5-2-5.08_1x02_P5.08mm_Horizont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
J2: EXT_ALARM_12V; TerminalBlock_Phoenix_MKDS-1,5-2-5.08_1x02_P5.08mm_Horizont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
J3: UART_HDR; PinHeader_1x04_P2.54mm_Vertical
J4: OLED_I2C; PinHeader_1x04_P2.54mm_Vertical
L1: 6.8uH; L_Coilcraft_XAL5030-XXX
LS1: PS1240_OR_SPKR; Buzzer_TDK_PS1240P02BT_D12.2mm_H6.5mm
NT1: NetTie_AGND_GND; NetTie-2_SMD_Pad0.5mm
Q1: AO3407A; SOT-23
Q2: IRLML6344; SOT-23
Q3: MMBFJ177_DNP; SOT-23
Q4: 2N7002; SOT-23
Q5: AO3400A; SOT-23
R1, R7, R8, R13, R24, R26: 10k; R_0603_1608Metric
R2, R4, R15, R16, R22: 100k; R_0603_1608Metric
R3, R12, R18: DNP; R_0603_1608Metric
R5: 43.2k; R_0603_1608Metric
R6: 10k_DNP; R_0603_1608Metric
R9, R10, R28: 4.7k; R_0603_1608Metric
R11, R29: 1k; R_0603_1608Metric
R14, R23: 100R; R_0603_1608Metric
R17: 15k; R_0603_1608Metric
R19: 270R; R_0603_1608Metric
R20, R30: 330R; R_0603_1608Metric
R21, R25: 2.2k; R_0603_1608Metric
R27: 0R_OR_5V; R_0603_1608Metric
S1: ME3-CO; TestPoint_Pad_D1.5mm
S2: TGS2610-C00; TestPoint_Pad_D1.5mm
SW1: TEST_SELF_CHECK; SW_SPST_PTS647_Sx50
SW2: HUSH_OLED; SW_SPST_PTS647_Sx50
SW3: HW_MASTER_RST; SW_SPST_PTS647_Sx50
TP1: +12V; TestPoint_Pad_D1.5mm
TP2: +3V3; TestPoint_Pad_D1.5mm
TP3: AVDD; TestPoint_Pad_D1.5mm
TP4: GND; TestPoint_Pad_D1.5mm
TP5: VOUT; TestPoint_Pad_D1.5mm
TP6: VALVE_GATE; TestPoint_Pad_D1.5mm
TP7: I2C_SDA; TestPoint_Pad_D1.5mm
TP8: I2C_SCL; TestPoint_Pad_D1.5mm
TP9: EN_PAD; TestPoint_Pad_D1.5mm
TP10: BOOT_PAD; TestPoint_Pad_D1.5mm
TP11: LPG_ADC; TestPoint_Pad_D1.5mm
TP12: NRST; TestPoint_Pad_D1.5mm
U1: ESP32-C3-MINI-1; ESP32-C6-MINI-1
U2: LMR33620ADDAR; TI_SO-PowerPAD-8_ThermalVias
U3: LMP91000SDE; WSON-14-1EP_4.0x4.0mm_P0.5mm_EP2.6x2.6mm
U4: REF3325; SOT-23
U5: 74LVC1G08; SOT-23-5
U6: TPS3823-33; SOT-23-5

Connections:
+3V3: C7.2, C8.1, C9.1, C10.1, C11.1, C12.1, C15.2, C16.2, C22.2, C23.2, C29.1, FB1.1, J3.1 (3V3), J4.2 (3V3), L1.2, R4.2, R6.1, R7.1, R8.1, R9.1, R10.1, R20.2, R26.2, R27.1, R30.1, S2.3 (SNS+), TP2.1, U1.3 (3V3), U5.5 (VCC), U6.5 (VDD)
+12V: C1.1, C2.1, C3.1, C4.1, C24.1, C26.1, D2.1, D3.1, D7.1, J2.1 (EXT_ALM+), LS1.1, Q1.2 (S), R2.1, R21.1, R25.1, TP1.1, U2.2 (VIN)
+12V_F: D1.1, F1.2, Q1.3 (D)
+12V_IN: F1.1, J1.1 (+12V_IN)
AGND: C13.1, C14.1, C18.1, C19.2, C20.2, NT1.2, U3.1 (DGND), U3.2 (MENB), U3.7 (AGND), U3.15 (GND), U4.3 (GND)
AVDD: C13.2, C14.2, C18.2, C19.1, FB1.2, TP3.1, U3.6 (VDD), U4.1 (IN)
BLU_A: D6.2, R21.2
BLU_K: D6.1, Q4.3 (D)
BOOT_N: R8.2, TP10.1, U1.23 (IO9_BOOT_N)
BUCK_BOOT: C5.1, U2.7 (BOOT)
BUCK_EN: R2.2, R3.1, U2.3 (EN)
BUCK_FB: C7.1, R4.1, R5.1, U2.5 (FB)
BUCK_SW: C5.2, L1.1, U2.8 (SW)
BUCK_VCC: C6.1, U2.6 (VCC)
BUZZER: R23.1, U1.6 (IO3_BUZZER)
BUZ_B: Q5.1 (G), R23.2, R24.1
BUZ_K: D7.2, LS1.2, Q5.3 (D), R25.2
CE: S1.3 (CE), U3.14 (CE)
GND: C1.2, C2.2, C3.2, C4.2, C6.2, C8.2, C9.2, C10.2, C11.2, C12.2, C15.1, C16.1, C17.2, C22.1, C23.1, C24.2, C25.2, C26.2, C27.2, C28.1, C29.2, C30.2, C31.1, D1.2, D4.1, D5.1, D9.2, D10.2, D11.2, J1.2 (GND), J3.4 (GND), J4.1 (GND), NT1.1, Q2.2 (S), Q4.2 (S), Q5.2 (S), R1.2, R3.2, R5.2, R15.2, R17.2, R18.2, R22.2, R24.2, R28.2, S2.1 (HTR-), SW1.2, SW2.2, SW3.2, TP4.1, U1.1 (GND), U1.2 (GND), U1.11 (GND), U1.14 (GND), U1.36 (GND), U1.37 (GND), U1.38 (GND), U1.39 (GND), U1.40 (GND), U1.41 (GND), U1.42 (GND), U1.43 (GND), U1.44 (GND), U1.45 (GND), U1.46 (GND), U1.47 (GND), U1.48 (GND), U1.49 (GND), U1.50 (GND), U1.51 (GND), U1.52 (GND), U1.53 (GND), U2.1 (PGND), U2.9 (GND), U5.3 (GND), U6.2 (GND)
GRN_A: D5.2, R20.1
HUSH_N: C30.1, D10.1, R7.2, SW2.1, U1.22 (IO8_HUSH_N)
I2C_SCL: J4.3 (SCL), R10.2, TP8.1, U1.19 (IO5_SCL), U3.3 (SCL)
I2C_SDA: J4.4 (SDA), R9.2, TP7.1, U1.18 (IO4_SDA), U3.4 (SDA)
LED_BLU: Q4.1 (G), R22.1, U1.27 (IO19_LED_BLU)
LED_RED: R19.1, U1.26 (IO18_LED_RED)
LPG_ADC: C28.2, R6.2, R29.2, TP11.1, U1.5 (IO2_LPG_ADC)
LPG_HTR: R27.2, S2.4 (HTR+)
LPG_SNS: R28.1, R29.1, S2.2 (SNS-)
MR_N: C31.2, D11.1, SW3.1, TP9.1, U6.3 (~MR)
NRST: TP12.1, U1.8 (EN_NRST), U6.1 (~RESET)
Q1_G: D3.2, Q1.1 (G), R1.1
RE: S1.2 (RE), U3.13 (RE)
RED_A: D4.2, R19.2
TEST_N: C27.1, D8.1, D9.1, R26.1, SW1.1, U1.16 (IO10_TEST_N)
TIA_C1: C21.1, R12.1, U3.10 (C1)
TIA_C2: C21.2, R12.2, U3.9 (C2)
UART_RX: J3.3 (RX), U1.30 (RXD0)
UART_TX: J3.2 (TX), U1.31 (TXD0)
VALVE_DRV: R13.1, R14.2, U5.4 (Y)
VALVE_EN: R13.2, U1.20 (IO6_VALVE_EN), U5.1 (A), U5.2 (B)
VALVE_GATE: Q2.1 (G), R14.1, R15.1, TP6.1
VALVE_NEG: D2.2, J2.2 (EXT_ALM-), Q2.3 (D), R16.1
VALVE_SENSE: C25.1, R16.2, R17.1, U1.13 (IO1_VALVE_SNS)
VOUT: R11.2, TP5.1, U3.8 (VOUT)
VOUT_ADC: C17.1, R11.1, U1.12 (IO0_VOUT_ADC)
VREF: C20.1, U3.11 (VREF), U4.2 (OUT)
WDI: R18.1, U1.21 (IO7_WDI), U6.4 (WDI)
WE: S1.1 (WE), U3.12 (WE)
YLW_A: D8.2, R30.2

Notes on the sheet:
BLOCK 1: 12V INPUT PROTECTION & 3.3V 2A SYNCHRONOUS BUCK CONVERTER (LMR33620ADDAR)
BLOCK 2: HARDWARE WATCHDOG (TPS3823-33), SAFETY INTERLOCK (74LVC1G08) & 12V EXTERNAL ALARM OUTPUT (J2)
BLOCK 3: DUAL GAS SENSORS — CO (ME3-CO + LMP91000 AFE) & LPG (FIGARO TGS2610-C00) + I2C OLED (J4)
BLOCK 4: ESP32-C3-MINI-1 WIRELESS MCU, DYNAMIC AUDIO SPEAKER (CDM-12008), LEDS, BUTTONS & UART

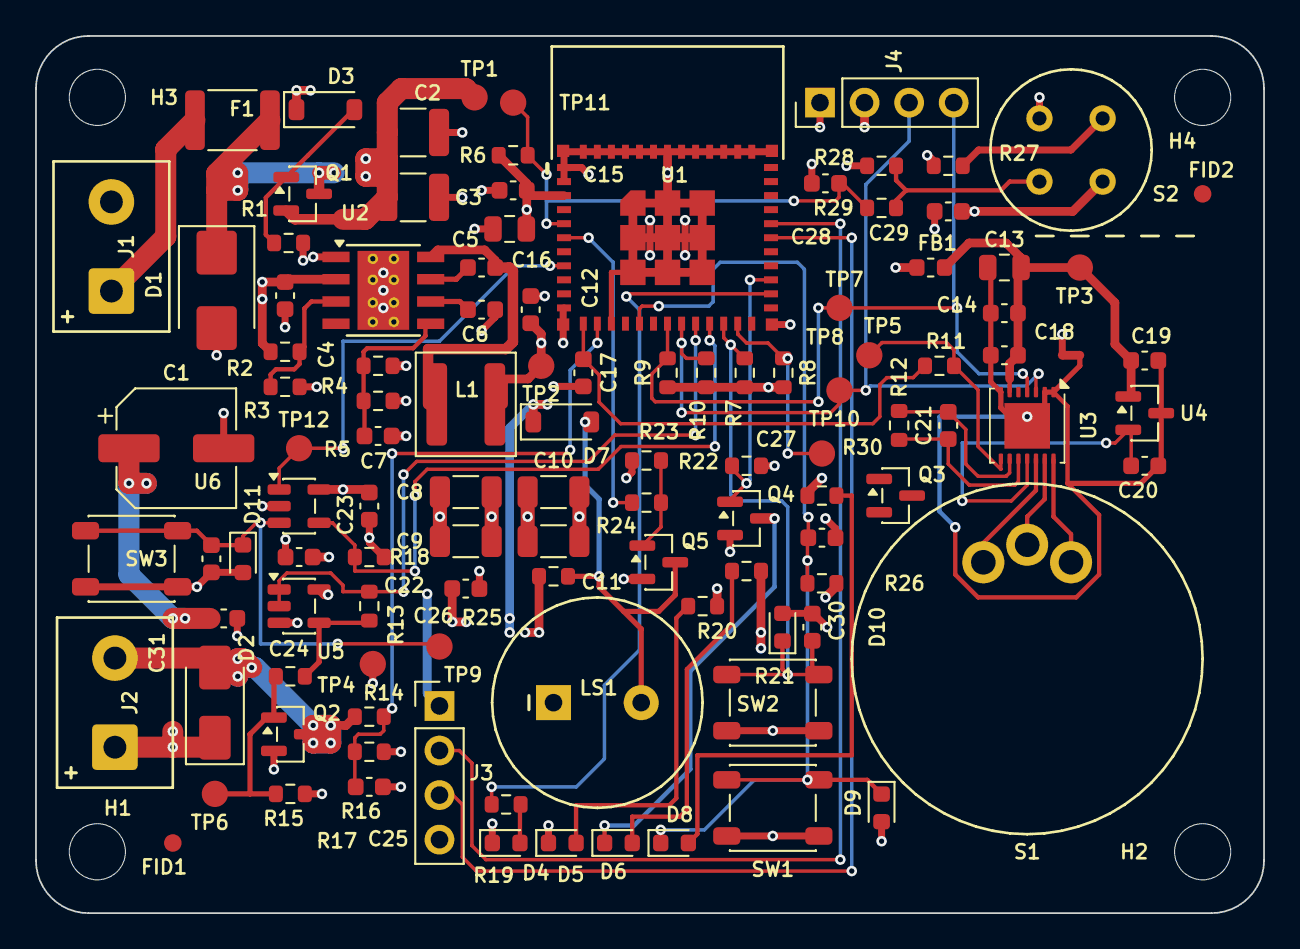
[picture p4: board co_detector_controller.kicad_pcb from above]

Board: 4 copper layers, 70.0 x 50.0 mm, 115 parts (0 on the bottom side), 49 nets.
