naoufalelhlou22/co-detector-controller/(commit log)

2026-11-08 Initial commit: Smart Dual Gas Detector (CO + LPG) controller hardware design and PCBA package
    [BOM_engineering_master.csv, JLCPCB_BOM.csv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]
2026-11-08 cad: add 3D STEP export of PCB assembly for SolidWorks integration
    [co_detector_controller.step]
2026-11-08 cad: add complete 3D enclosure CAD package (STL, DXF, OpenSCAD, SolidWorks API macro)
    [co_detector_enclosure.scad, co_detector_front_cover.stl, co_detector_light_pipe.stl, co_detector_rear_chassis.stl, co_detector_test_button.stl, co_detector_wall_bracket.stl, front_face_ui_cutouts.dxf, pcb_mounting_boss_pattern.dxf]
2026-11-08 cad: add native SolidWorks 3D parts (.SLDPRT), assembly (.SLDASM), and STEP files for enclosure (pure enclosure without PCBA)
    [CO_Enclosure_Assembly.SLDASM, CO_Enclosure_Assembly.step, CO_Enclosure_Chassis_Base.SLDPRT, CO_Enclosure_Chassis_Base.step, CO_Enclosure_Front_Cover.SLDPRT, CO_Enclosure_Front_Cover.step, CO_Enclosure_Wall_Bracket.SLDPRT, CO_Enclosure_Wall_Bracket.step]
2026-11-08 cad: add AutoCAD Mechanical production drawing package (ISO A3 DXF, AutoLISP, and 3D STEP import script)
    [co_detector_enclosure_drawing.dxf]
2026-11-08 feat: add interactive 3D enclosure web viewer with exploded view and thermal animation
2026-11-08 docs: add 3D photorealistic product render and technical CAD exploded isometric render
2026-11-08 feat(cad): complete rebuild of enclosure with 100% PCBA alignment (Rev 3.0)
    - Purge all previous misaligned 3D CAD models and scripts
    - Fix coordinate inversion bug: Cartesian Y_cad = 50.0 - Y_kicad
    - Ground-truth extraction of all 115 footprints from co_detector_controller.kicad_pcb
    - AutoCAD Mechanical 2027 ISO A3 master production blueprint (.dxf)
    - SolidWorks 2026 native models: CO_Enclosure_Chassis_Base, Front_Cover, Wall_Bracket (.SLDPRT, .SLDASM)
    - Neutral standard B-Rep STEP AP214 and watertight binary STL models
    - 0.96-inch OLED display bezel window at (48.50, 32.50) with internal PMMA lens shelf
    - S2 LPG thermal chimney at top right isolated by 29mm from S1 CO diffusion well
    - Left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
    [CO_Enclosure_Assembly.SLDASM, CO_Enclosure_Assembly.step, CO_Enclosure_Chassis_Base.SLDPRT, CO_Enclosure_Chassis_Base.step, CO_Enclosure_Chassis_Base.stl, CO_Enclosure_Front_Cover.SLDPRT, CO_Enclosure_Front_Cover.step, CO_Enclosure_Front_Cover.stl]
2026-11-08 feat(render): generate high-definition photorealistic product render based on CAD models
    - Add scripts/render_photorealistic_product.py (2560x1440 HD render engine)
    - Render true physical squircle 86x66x28mm in Cycoloy PC/ABS off-white matte
    - Active 0.96-inch OLED telemetry display with glass streak reflection
    - Radiant status LEDs with Gaussian bloom, tactile buttons SW1/SW2
    - Concentric CO diffusion louvers and LPG natural convection chimney
    - Add hero product render to README.md and engineering blueprint image
2026-11-08 feat(rev4): complete PCB and zero-collision enclosure redesign with battery backup (Rev 4.0)
    [CO_Enclosure_Assembly.SLDASM, CO_Enclosure_Assembly.step, CO_Enclosure_Chassis_Base.SLDPRT, CO_Enclosure_Chassis_Base.step, CO_Enclosure_Chassis_Base.stl, CO_Enclosure_Front_Cover.SLDPRT, CO_Enclosure_Front_Cover.step, CO_Enclosure_Front_Cover.stl]
2026-11-08 chore(cleanup): remove obsolete rev4 scripts and CAD files, organize Stage 5 PCBA project structure
    [CO_Enclosure_Assembly.SLDASM, CO_Enclosure_Assembly.step, CO_Enclosure_Chassis_Base.SLDPRT, CO_Enclosure_Chassis_Base.step, CO_Enclosure_Chassis_Base.stl, CO_Enclosure_Front_Cover.SLDPRT, CO_Enclosure_Front_Cover.step, CO_Enclosure_Front_Cover.stl]
